n9wxu/fpga_cpu/basic/examples/VALLEY.JPG

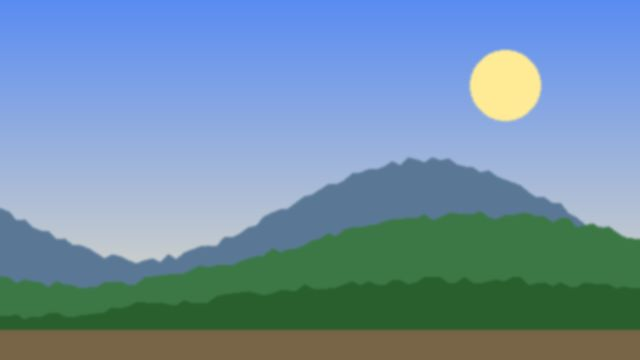
basic/examples/VALLEY.JPG
