n9wxu/fpga_cpu/sim/README.md

# sim

Simulator, assembler and measurement tools for the fpga_cpu ISA. Everything is
driven by [`../cpu/isa.yaml`](../cpu/isa.yaml).

```sh
make -C sim            # generate tables from isa.yaml, build sim/build/fsim (+ fsim-gui if SDL2 is installed)
make -C sim gui        # build sim/build/fsim-gui only
make -C sim test       # ISA self-test, every benchmark on every variant, device test
make -C sim measure    # full sweep -> docs/measurements.md
```

The Makefile creates `.venv/` (PyYAML) on first use. The GUI needs SDL2
(`brew install sdl2`); Dear ImGui is vendored in `third_party/imgui`.

## Layout

| Path | Contents |
|---|---|
| `tools/isa.py` | Loads `isa.yaml`, expands it into individual encodings, checks for overlaps and length-rule violations. Running `isa.py --selftest` does random encode/decode round trips. |
| `tools/gen.py` | Writes the C tables (`src/gen/`, not committed) and the encoding docs (`cpu/gen/encoding_*.md`) |
| `tools/asm.py` | Assembler: picks the shortest encoding that fits, settles branch sizes over repeated passes, writes a listing and per-encoding statistics |
| `tools/measure.py` | Runs every benchmark × variant × timing configuration and checks each output |
| `tools/bench_ref.py` | Python reference results for the benchmarks (`--update` rewrites the `; expect:` lines) |
| `tools/devtest.py` | Device test: runs `demo/devtest.s` headless and checks the keyboard queue, file service and board I/O |
| `tools/profile.py` | Flat profile by function from `fsim --profile` output and a symbol file |
| `tools/memlog.py` | Reads `fsim --log`: cycles, instructions and bus bytes per frame, and frames rebuilt from video-memory writes |
| `tools/mkfont.py` | Builds the 8×14 character ROM (`assets/font8x14.mem` for the FPGA, `src/font8x14.c` for the simulator) from the Terminus BDF |
| `src/cpu.c` | CPU core: decode, memory map, timing model, `cpu_step`/`cpu_run` |
| `src/dev.c` | I/O devices from [docs/io.md](../docs/io.md): console, frame timing, keyboard, video registers, sound, file service, board I/O |
| `src/video.c` | Video renderer: backdrop, bitmap (8-color / hi-color), sprite buffer, text; 640×360 doubled to 1280×720 |
| `src/front.c` | Shared by both front ends: options, image loading, symbols |
| `src/main.c` | Headless front end, `fsim` |
| `src/gui.cpp` | SDL2 + Dear ImGui front end, `fsim-gui` |
| `bench/` | Benchmarks plus `lib.s` (console output, decimal/hex printing, exit) |
| `demo/` | `video.s` (every display layer, double-buffered sprite), `hicolor.s` (palette and dither), `devtest.s` |
| `assets/` | Character ROM: `ter-u14n.bdf` (Terminus, SIL OFL 1.1, see `OFL.TXT`) and the generated `font8x14.mem` |

## Running a program

```sh
.venv/bin/python sim/tools/asm.py -v A prog.s -o prog.bin --lst prog.lst
sim/build/fsim -v A prog.bin              # --trace, --json, timing options: fsim -h
```

Programs start at `.org 0x1000` by default (`--load`, `--entry`). Both
front ends take the same options (`fsim -h`):

| Option | Effect |
|---|---|
| `-v A\|B` | encoding variant |
| `--disk DIR` | host directory served by the file service (default `./disk`) |
| `--sym FILE` | symbols, lines of `%06x name`; used by the GUI's disassembly |
| `--keys STRING` | preload the keyboard queue (`\n` = Enter, `\e` = Esc) |
| `--screenshot FILE` | write the 1280×720 display as PPM at exit |
| `--hw sim\|spartan3\|tang\|big` | the hardware (below): the video tier, the RAM, the colours and the clock; later options override parts of it |
| `--true-color` | show hi-color palette colors instead of the 3-bit dither |
| `--trace`, `--json FILE`, `-q` | headless only: instruction trace, statistics, no summary |
| `--dump A:N:FILE` | headless only: write N bytes of memory from A at exit |
| `--core c0\|c1\|c2\|c3` | a core configuration from the scaling ladder ([docs/cores.md](../docs/cores.md)); later timing options override parts of it |
| `--ext` | allow the optional extension X instructions (`DSTEP`, `MULPU`, `FSHR`, `FSHL`, `CLZ`; [cpu/isa.md](../cpu/isa.md)); without it they trap as illegal |
| `--profile FILE` | headless only: instructions and cycles per address; `tools/profile.py prog.sym FILE` totals them by function |
| `--log FILE` | headless only: a binary record of every instruction (address, length, start cycle) and data access (address, size, value); `tools/memlog.py` reads it |

The I/O registers and the memory layout are in [docs/io.md](../docs/io.md).
Headless, `CON_OUT` goes to stdout and `CON_IN` reads stdin.

## Hardware

`--hw` picks the machine a program was made for (`fsim -h` lists them). The clock is set so a program
runs at about the speed of the board's CPU (its measured MIPS at fsim's cycles per instruction on the
demos, about 1.5); video timing and the low tier's sound follow the clock.

| `--hw` | Machine | Clock | RAM | Video |
|---|---|---|---|---|
| `sim` (default) | the reference machine | 50 MHz | 1 MB | every mode, the 3-bit dither shown |
| `spartan3` | the Spartan-3 board (T1F, about 2 MIPS) | 3 MHz | 1 MB | the low tier: 8- and 16-colour bitmaps, no palette or video extensions; its sound player |
| `tang` | the Tang Nano 20K (T1F, about 6.5 MIPS) | 10 MHz | 8 MB | the high tier in true colour: palette, two playfields, line scroll, sprites, blitter |
| `big` | the reference machine for Doom | 50 MHz | 15 MB | as `sim` |

The Tang's 32-voice audio engine (F01000) is not simulated: the demos that play on it notice and run
silent, keeping time by the video frames.

## Programs

`tools/programs.py` builds the demos and benchmarks (the apps' Makefiles, fcc, the assembler,
`benchmarks/run.py`'s C builds, BASIC with the benchmark programs as its disk) into `build/programs/`
and lists them in `build/programs/catalog.tsv`: name, kind, the hardware it was made for, how to load
it. `--list` shows them; `FCC=...` points at another checkout's toolchain. A program whose build fails is
left out. fsim-gui and the web page (`make -C web progs`) offer what was built.

```sh
.venv/bin/python sim/tools/programs.py      # build/programs/*.bin, catalog.tsv
sim/build/fsim-gui                          # with no image: the first program, on its own hardware
```

## GUI

```sh
sim/build/fsim-gui sim/build/video.bin --sym video.sym
```

| Window | Contents |
|---|---|
| Display | the 1280×720 output. Click it to type: keys go to the keyboard queue as the io.md key codes |
| Controls | Run (F5), Stop, Step (F11), Step Over (F10, steps over `JAL`/`JALR`), Step Out (runs until a `JR` returns from the current frame), Reset (reloads the image), speed: real time (at the hardware's clock) or as fast as possible |
| Program and hardware | the program (demos, benchmarks and programs from the catalogue, `--programs FILE`) and the hardware (`--hw`); a choice builds the machine again. A program brings its own hardware; another can be picked after it |
| Registers | r0–r15 (editable while stopped), the pairs with symbol names, PC, NZCV, cycles, frame and scan line |
| Disassembly | follows the PC, shows labels from `--sym`; click a line to toggle a breakpoint; go to an address or symbol |
| Memory | hex and ASCII over the whole 24-bit space; go to an address or symbol |
| Serial console | `CON_OUT` text; a line typed here is sent to `CON_IN` with `\n` |
| Board | the starter board's 7-segment display, LEDs, slide switches and push buttons |
| Statistics | IPC, I-cache, branches, stall breakdown, fusion candidates |

Sound plays the three voices through SDL audio. The window layout is
saved in `~/.fsim_gui.ini`.

Scripted runs, for checking the GUI without clicking:
`--paused` starts stopped; `--frames N --screenshot-window FILE.bmp` runs N
display frames, saves the whole window and exits; `FSIM_GUI_SELFTEST=1`
checks breakpoints, Step Over/Out and key translation on `demo/video.s`.

## Assembly syntax

```asm
        ADD   r1, r2, r3        ; three-operand
        ADD   r1, r2            ; r1 = r1 + r2 (assembler picks the 16-bit form)
        LDW   r1, [p2 + 6]      ; pair + displacement
        LDW   r1, [p2 + r3*2]   ; pair + sign-extended index (r3.z*2 = zero-extended)
        LDW   r1, [p2]+         ; post-increment     STW r1, -[p2]   pre-decrement
        LDW   r1, [label]       ; direct (variant A expands to LEA p0 + LDW)
        BNE   loop              ; EQ NE CS/HS CC/LO MI PL VS VC HI LS GE LT GT LE AL/RA
```

- Registers are `r0`–`r15`. Pairs are `p0`–`p7`, with `sp` = `p7` and `lr` = `p6`.
- Pseudo-instructions: `LI LA CALL RET PUSH POP PUSHP POPP INC DEC CLR TST`.
- Directives: `.org .equ .byte .word .long .ascii .asciz .align .space .include`, and `.ifdef NAME` / `.ifndef NAME` / `.else` / `.endif` with names from `asm.py -D NAME`.

## Timing model

CPU and SRAM share one 50 MHz clock and one 32-bit memory port.

`--xram MB` adds simulator-only expansion RAM at `100000` (up to 14 MB,
to `EFFFFF`), with the same timing as the SRAM, for programs larger than
the base board (benchmarks/doom). Without it, that range is unmapped.

- **Every instruction takes 1 cycle**, plus:
  - I-cache misses: 1 cycle to start, then 1 cycle per word, word by word.
  - The stream buffer prefetches the next line during idle port cycles.
  - Taken branches: 2 cycles.
  - A load whose result the next instruction uses: 1 cycle.
  - Video scan-out takes port cycles: 4 every 56 by default.
  - Each I/O access: 2 cycles.
  - A 32-bit pair access that spans two SRAM words: 1 cycle.
- **Fusion candidates are always counted.** `--fuse` applies them: the second instruction issues free when both instructions fit in the 64-bit fetch window.
  - Kinds: `cmpbr` (CMP/CMPI/CPC + Bcc), `addadc` (ADD+ADC or SUB+SBC on a pair), `leamem` (LEA + a load or store through that pair), `ldpair` (two LDW or STW to adjacent words) and `alubr` (any other flag-setting ALU op + Bcc, so `DEC r; BNE loop` behaves like a DBNZ instruction).
  - `--fuse=cmpbr,alubr` applies only the listed kinds. Candidates are counted the same way whatever is applied.
- **Dual issue** (`--dual`): an instruction issues free beside the one before it when slot 2 can take it and the two are independent.
  - Slot 1 takes anything except a control transfer. Slot 2 takes a simple ALU op (no shift, multiply or pointer op), `MOVI`, or a branch.
  - The pair must fit the fetch window, and slot 2 must not read a register or the flags that slot 1 writes, or write the same register.
  - `--dual` (banked) gives the register file one write port per even/odd bank, so the two must write opposite banks. `--dual=ports` models a full second write port.
  - Fusion is tried first. An instruction joins at most one group, so there is no three-way issue.
- **SRAM port counters:** words used by I-fetch (misses, stream buffer) and data, plus the instruction bytes the core consumes per cycle. `make measure` reports them, and estimates speed per LUT for each option.
