n9wxu/fpga_cpu/pcb/README.md

# pcb

RP2350 expansion board for headers A2/B1: SD card, keyboard, sound (PWM + amplifier), RTC, and the UART link to the FPGA.

Future expansion (VRAM, HDMI, game controllers) is not designed yet.
