n9wxu/fpga_cpu/apps/sidplay/out/screen_syncrider.png

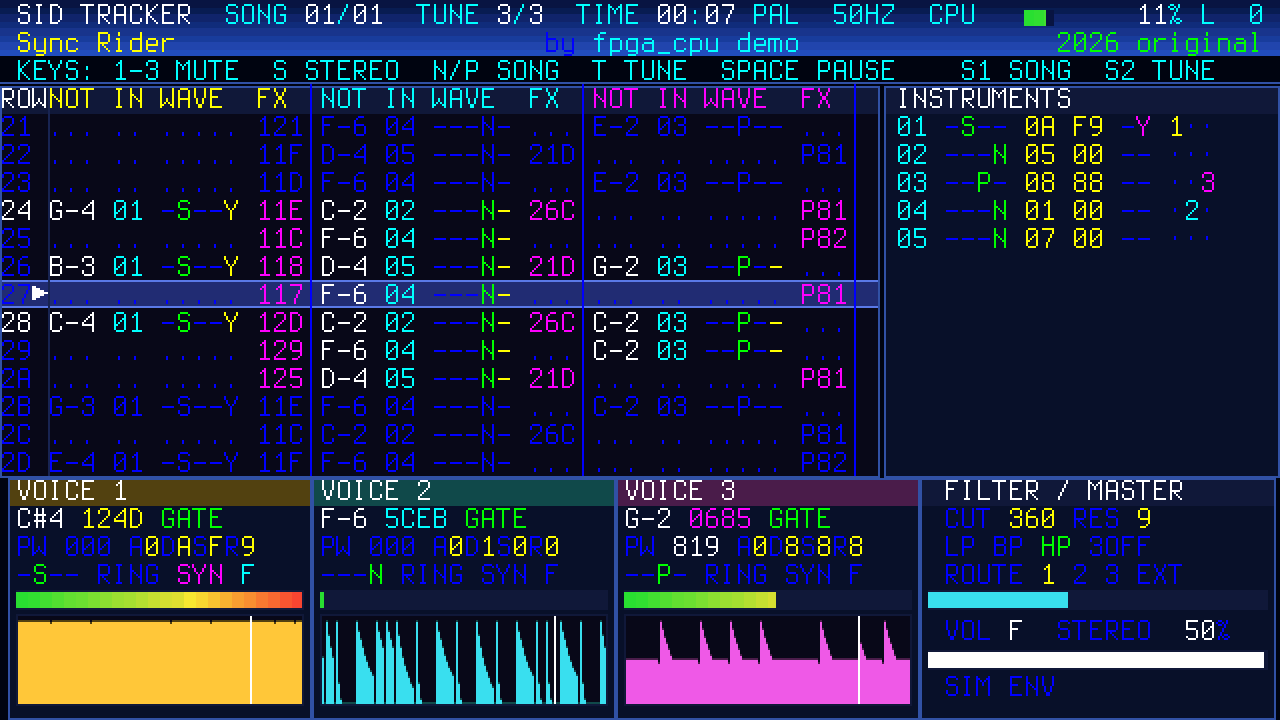
apps/sidplay/out/screen_syncrider.png
