n9wxu/fpga_cpu/docs/measurements.md

# Measurements

Generated by `sim/tools/measure.py`. Do not edit; rerun `make -C sim measure`.

The benchmarks are hand-written assembly (`sim/bench`). They show how the encodings and the
timing model behave, but they are small and fit in any I-cache. Code-size and I-cache
conclusions need compiled code: the BASIC interpreter via the LLVM backend.

CPU and SRAM share one 50 MHz clock. Every run was checked against the Python reference results.

## Opcode space

| variant | 16-bit share | 16-bit used | 32-bit share | 32-bit used | encodings |
|---|---|---|---|---|---|
| A | 81.2% | 96.1% | 18.8% | 85.7% | 153 |
| B | 50.0% | 94.8% | 50.0% | 69.6% | 151 |

## Static code size

| benchmark | A bytes | A 16-bit | B bytes | B 16-bit | B/A | B expanded |
|---|---|---|---|---|---|---|
| arith32 | 252 | 76% | 262 | 72% | 1.040 | 0 |
| fib | 200 | 70% | 210 | 64% | 1.050 | 0 |
| hello | 150 | 73% | 160 | 64% | 1.067 | 0 |
| lines | 274 | 75% | 286 | 70% | 1.044 | 0 |
| memops | 300 | 64% | 310 | 59% | 1.033 | 0 |
| sieve | 228 | 73% | 242 | 66% | 1.061 | 0 |
| tokenize | 328 | 83% | 350 | 75% | 1.067 | 0 |
| **total** | **1732** | | **1820** | | **1.051** | |

## Dynamic performance (base configuration)

| benchmark | insts | A cycles | A CPI | A 16-bit exec | B cycles | B CPI | B/A |
|---|---|---|---|---|---|---|---|
| arith32 | 140723 | 181028 | 1.286 | 72% | 181034 | 1.286 | 1.0000 |
| fib | 208041 | 335884 | 1.615 | 68% | 335879 | 1.614 | 1.0000 |
| hello | 82 | 198 | 2.415 | 93% | 193 | 2.354 | 0.9747 |
| lines | 810610 | 1255810 | 1.549 | 96% | 1255815 | 1.549 | 1.0000 |
| memops | 155962 | 254232 | 1.630 | 97% | 254255 | 1.630 | 1.0001 |
| sieve | 722099 | 1114745 | 1.544 | 69% | 1114746 | 1.544 | 1.0000 |
| tokenize | 648700 | 1114640 | 1.718 | 92% | 1114640 | 1.718 | 1.0000 |
| **geomean** | | | | | | | **0.9964** |

## Where the cycles go (variant A, base)

| benchmark | issue | ifetch | taken branch | load-use | video | I/O | pair split |
|---|---|---|---|---|---|---|---|
| arith32 | 78% | 0.0% | 22.2% | 0.0% | 0.0% | 0.0% | 0.0% |
| fib | 62% | 0.0% | 32.6% | 3.3% | 2.2% | 0.0% | 0.0% |
| hello | 41% | 16.2% | 18.2% | 7.6% | 1.5% | 15.2% | 0.0% |
| lines | 65% | 0.0% | 26.1% | 9.2% | 0.1% | 0.0% | 0.0% |
| memops | 61% | 0.0% | 27.4% | 10.5% | 0.7% | 0.0% | 0.0% |
| sieve | 65% | 0.0% | 31.0% | 2.9% | 1.2% | 0.0% | 0.0% |
| tokenize | 58% | 0.0% | 24.5% | 13.1% | 4.2% | 0.0% | 0.0% |

## Fusion candidates (variant A), per 100 instructions

| benchmark | cmp+branch | add+adc pair | lea+mem | ldw/stw pair | alu+branch | speedup with fusion |
|---|---|---|---|---|---|---|
| arith32 | 14.3 | 14.2 | 0.0 | 0.0 | 0.1 | 1.285x |
| fib | 10.5 | 0.0 | 0.0 | 0.0 | 0.0 | 1.078x |
| hello | 18.3 | 0.0 | 1.2 | 0.0 | 0.0 | 1.076x |
| lines | 7.9 | 0.0 | 0.0 | 0.0 | 18.2 | 1.169x |
| memops | 0.0 | 0.0 | 0.0 | 0.0 | 22.3 | 1.153x |
| sieve | 20.0 | 0.0 | 0.0 | 0.0 | 4.5 | 1.166x |
| tokenize | 28.7 | 0.0 | 0.0 | 0.0 | 0.0 | 1.232x |
| **geomean** |  |  |  |  |  | **1.163x** |

## Fusion candidates (variant B), per 100 instructions

| benchmark | cmp+branch | add+adc pair | lea+mem | ldw/stw pair | alu+branch | speedup with fusion |
|---|---|---|---|---|---|---|
| arith32 | 14.3 | 14.2 | 0.0 | 0.0 | 0.1 | 1.285x |
| fib | 10.5 | 0.0 | 0.0 | 0.0 | 0.0 | 1.078x |
| hello | 18.3 | 0.0 | 1.2 | 0.0 | 0.0 | 1.078x |
| lines | 7.9 | 0.0 | 0.0 | 0.0 | 18.2 | 1.169x |
| memops | 0.0 | 0.0 | 0.0 | 0.0 | 22.3 | 1.153x |
| sieve | 20.0 | 0.0 | 0.0 | 0.0 | 4.5 | 1.166x |
| tokenize | 28.7 | 0.0 | 0.0 | 0.0 | 0.0 | 1.232x |
| **geomean** |  |  |  |  |  | **1.164x** |

## Dual issue (variant A)

Slot 2 takes simple ALU ops, MOVI or a branch; slot 1 takes anything but a control transfer. Paired instructions must be independent (no register or flag dependence). Banked: the two must write opposite even/odd register banks.

| benchmark | paired, banked | paired, ports | slot 2 alu / movi / branch | top blockers (banked) | speedup banked | speedup ports | dual + branch fusion |
|---|---|---|---|---|---|---|---|
| arith32 | 28.5% | 28.5% | 100 / 0 / 0% | flags 14%, slot2 14% | 1.284x | 1.285x | 1.499x |
| fib | 5.3% | 10.5% | 100 / 0 / 0% | slot2 32%, flags 11% | 1.039x | 1.078x | 1.102x |
| hello | 17.1% | 17.1% | 0 / 0 / 100% | raw 18%, flags 18% | 1.070x | 1.070x | 1.193x |
| lines | 21.6% | 23.9% | 100 / 0 / 0% | raw 14%, flags 8% | 1.125x | 1.153x | 1.206x |
| memops | 5.3% | 22.4% | 100 / 0 / 0% | bank 22%, flags 17% | 1.038x | 1.153x | 1.153x |
| sieve | 15.5% | 20.6% | 71 / 0 / 29% | flags 24%, slot1 15% | 1.099x | 1.133x | 1.326x |
| tokenize | 4.9% | 4.9% | 7 / 3 / 90% | flags 29%, raw 26% | 1.042x | 1.042x | 1.254x |
| **geomean** | | | | | **1.097x** | **1.128x** | **1.242x** |

Blockers are counted per instruction: window = the pair does not fit the fetch window, slot1/slot2 = an instruction class the slot cannot take, raw/waw = register dependence, bank = both write the same bank, flags = slot 2 reads flags that slot 1 writes.

## SRAM port use (variant A, all benchmarks)

Share of all cycles. Video is the fixed scan-out reservation (4 of every 56 cycles). Demand is the instruction bytes the core consumes per cycle; the port can supply 4.

| configuration | instruction fetch | data | video | idle | demand B/cycle | cycles vs base |
|---|---|---|---|---|---|---|
| base | 0.0% | 13.5% | 7.1% | 79.4% | 1.46 | 1.000 |
| fuse-br | 0.0% | 15.8% | 7.1% | 77.0% | 1.71 | 0.877 |
| dual+br | 0.0% | 16.8% | 7.1% | 76.1% | 1.82 | 0.805 |
| ic64 | 2.3% | 13.3% | 7.1% | 77.3% | 1.44 | 1.008 |
| ic64+dual+br | 2.8% | 16.5% | 7.1% | 73.6% | 1.78 | 0.814 |
| nocache | 62.0% | 12.2% | 7.1% | 18.7% | 1.32 | 1.063 |
| nocache+br | 72.5% | 14.3% | 7.1% | 6.1% | 1.54 | 0.935 |
| nocache+dual | 68.0% | 13.4% | 7.1% | 11.5% | 1.45 | 0.969 |

The benchmarks fit in a 64 B cache except `tokenize` and `hello`, so the miss path is only really exercised by the no-cache rows until compiled BASIC is measured.

## Speed per LUT (variant A, estimates)

LUT figures are design estimates in `sim/tools/measure.py`, not synthesis results. Speedup is the geomean over benchmarks against base.

| option | speedup | extra LUTs (est.) | speedup % per 100 LUTs | what the LUTs buy |
|---|---|---|---|---|
| bp1 | 1.140x | 30–80 | 25.5 | resolve taken branches one stage earlier: target adder and redirect in decode |
| fuse-cmpbr | 1.095x | 30–60 | 21.2 | pair detect, flags forwarded straight into the branch decision |
| fuse-br | 1.141x | 40–80 | 23.4 | as fuse-cmpbr, plus the register write of the ALU half |
| fuse | 1.163x | 150–250 | 8.2 | all kinds: adds a 32-bit carry across ADD+ADC, LEA into the AGU, paired LDW/STW |
| dual | 1.097x | 300–450 | 2.6 | slot-2 decoder and 16-bit ALU, two more register-file read copies, forwarding, pairing check, flag merge |
| dual-ports | 1.128x | 360–570 | 2.8 | as dual, plus a second full write port (replicated file or LVT) |

## Configuration sweep: cycles relative to base (geomean over benchmarks)

| configuration | description | A | B |
|---|---|---|---|
| fuse | base + macro-op fusion | 0.859 | 0.859 |
| noprefetch | base without the stream buffer | 1.000 | 1.000 |
| nocache | no I-cache: every fetch from SRAM | 1.063 | 1.075 |
| ic512 | 512 B I-cache | 1.000 | 1.000 |
| ic1k | 1 KB I-cache | 1.000 | 1.000 |
| ic4k | 4 KB I-cache | 1.000 | 1.000 |
| line8 | 8 B lines | 0.992 | 0.993 |
| line32 | 32 B lines | 1.002 | 0.999 |
| novideo | no video traffic | 0.983 | 0.983 |
| bp1 | 1-cycle taken-branch penalty | 0.877 | 0.877 |
| fuse-cmpbr | fuse CMP+Bcc only | 0.913 | 0.913 |
| fuse-br | fuse CMP+Bcc and ALU+Bcc (DEC+BNE = DBNZ) | 0.877 | 0.876 |
| dual | dual issue, even/odd write banks | 0.912 | 0.911 |
| dual-ports | dual issue, full second write port | 0.886 | 0.886 |
| dual+br | dual issue (banked) + branch fusion | 0.805 | 0.805 |
| bp1+br | 1-cycle branch + branch fusion | 0.745 | 0.744 |
| bp1+dual+br | 1-cycle branch + dual (banked) + branch fusion | 0.677 | 0.676 |
| nocache+br | no I-cache + branch fusion | 0.935 | 0.945 |
| nocache+dual | no I-cache + dual issue | 0.969 | 0.978 |
| ic64 | 64 B I-cache (miss-path stress) | 1.008 | 1.009 |
| ic64+br | 64 B I-cache + branch fusion | 0.886 | 0.886 |
| ic64+dual+br | 64 B I-cache + dual + branch fusion | 0.814 | 0.814 |

## I-cache misses per 1000 instructions

| benchmark | A ic512 | A ic1k | A base | B ic512 | B ic1k | B base |
|---|---|---|---|---|---|---|
| arith32 | 0.05 | 0.05 | 0.05 | 0.06 | 0.06 | 0.06 |
| fib | 0.03 | 0.03 | 0.03 | 0.02 | 0.02 | 0.02 |
| hello | 48.78 | 48.78 | 48.78 | 48.78 | 48.78 | 48.78 |
| lines | 0.00 | 0.00 | 0.00 | 0.00 | 0.00 | 0.00 |
| memops | 0.04 | 0.04 | 0.04 | 0.05 | 0.05 | 0.05 |
| sieve | 0.01 | 0.01 | 0.01 | 0.01 | 0.01 | 0.01 |
| tokenize | 0.01 | 0.01 | 0.01 | 0.01 | 0.01 | 0.01 |

## Most executed encodings (variant A, all benchmarks)

| encoding | share |
|---|---|
| `B/16` | 29.3% |
| `ADDI/16` | 11.4% |
| `ADD/16` | 11.1% |
| `CMPI/16` | 7.3% |
| `LDW.pi/16` | 5.8% |
| `CMP/16` | 4.8% |
| `CMPI/32` | 4.2% |
| `LDBU.pi/16` | 3.6% |
| `LDBU.x/32,ext=0,scale=1` | 2.9% |
| `STB.x/32,ext=0,scale=1` | 2.8% |
| `STB.pi/16` | 1.8% |
| `ADDP/16` | 1.7% |
| `ADD/32` | 1.3% |
| `LDBU.d/16` | 1.3% |
| `STB.d/16` | 1.2% |

## Most executed encodings (variant B, all benchmarks)

| encoding | share |
|---|---|
| `B/16` | 29.3% |
| `ADDI/16` | 11.4% |
| `ADD/16` | 11.1% |
| `CMPI/16` | 7.3% |
| `LDW.pi/16` | 5.8% |
| `CMP/16` | 4.8% |
| `CMPI/32` | 4.2% |
| `LDBU.pi/16` | 3.6% |
| `LDBU.x/32,ext=0,scale=1` | 2.9% |
| `STB.x/32,ext=0,scale=1` | 2.8% |
| `STB.pi/16` | 1.8% |
| `ADDP/16` | 1.7% |
| `ADD/32` | 1.3% |
| `LDBU.d/32` | 1.3% |
| `STB.d/32` | 1.2% |
