n9wxu/fpga_cpu/pcb/s3_expansion/s3_expansion.pdf

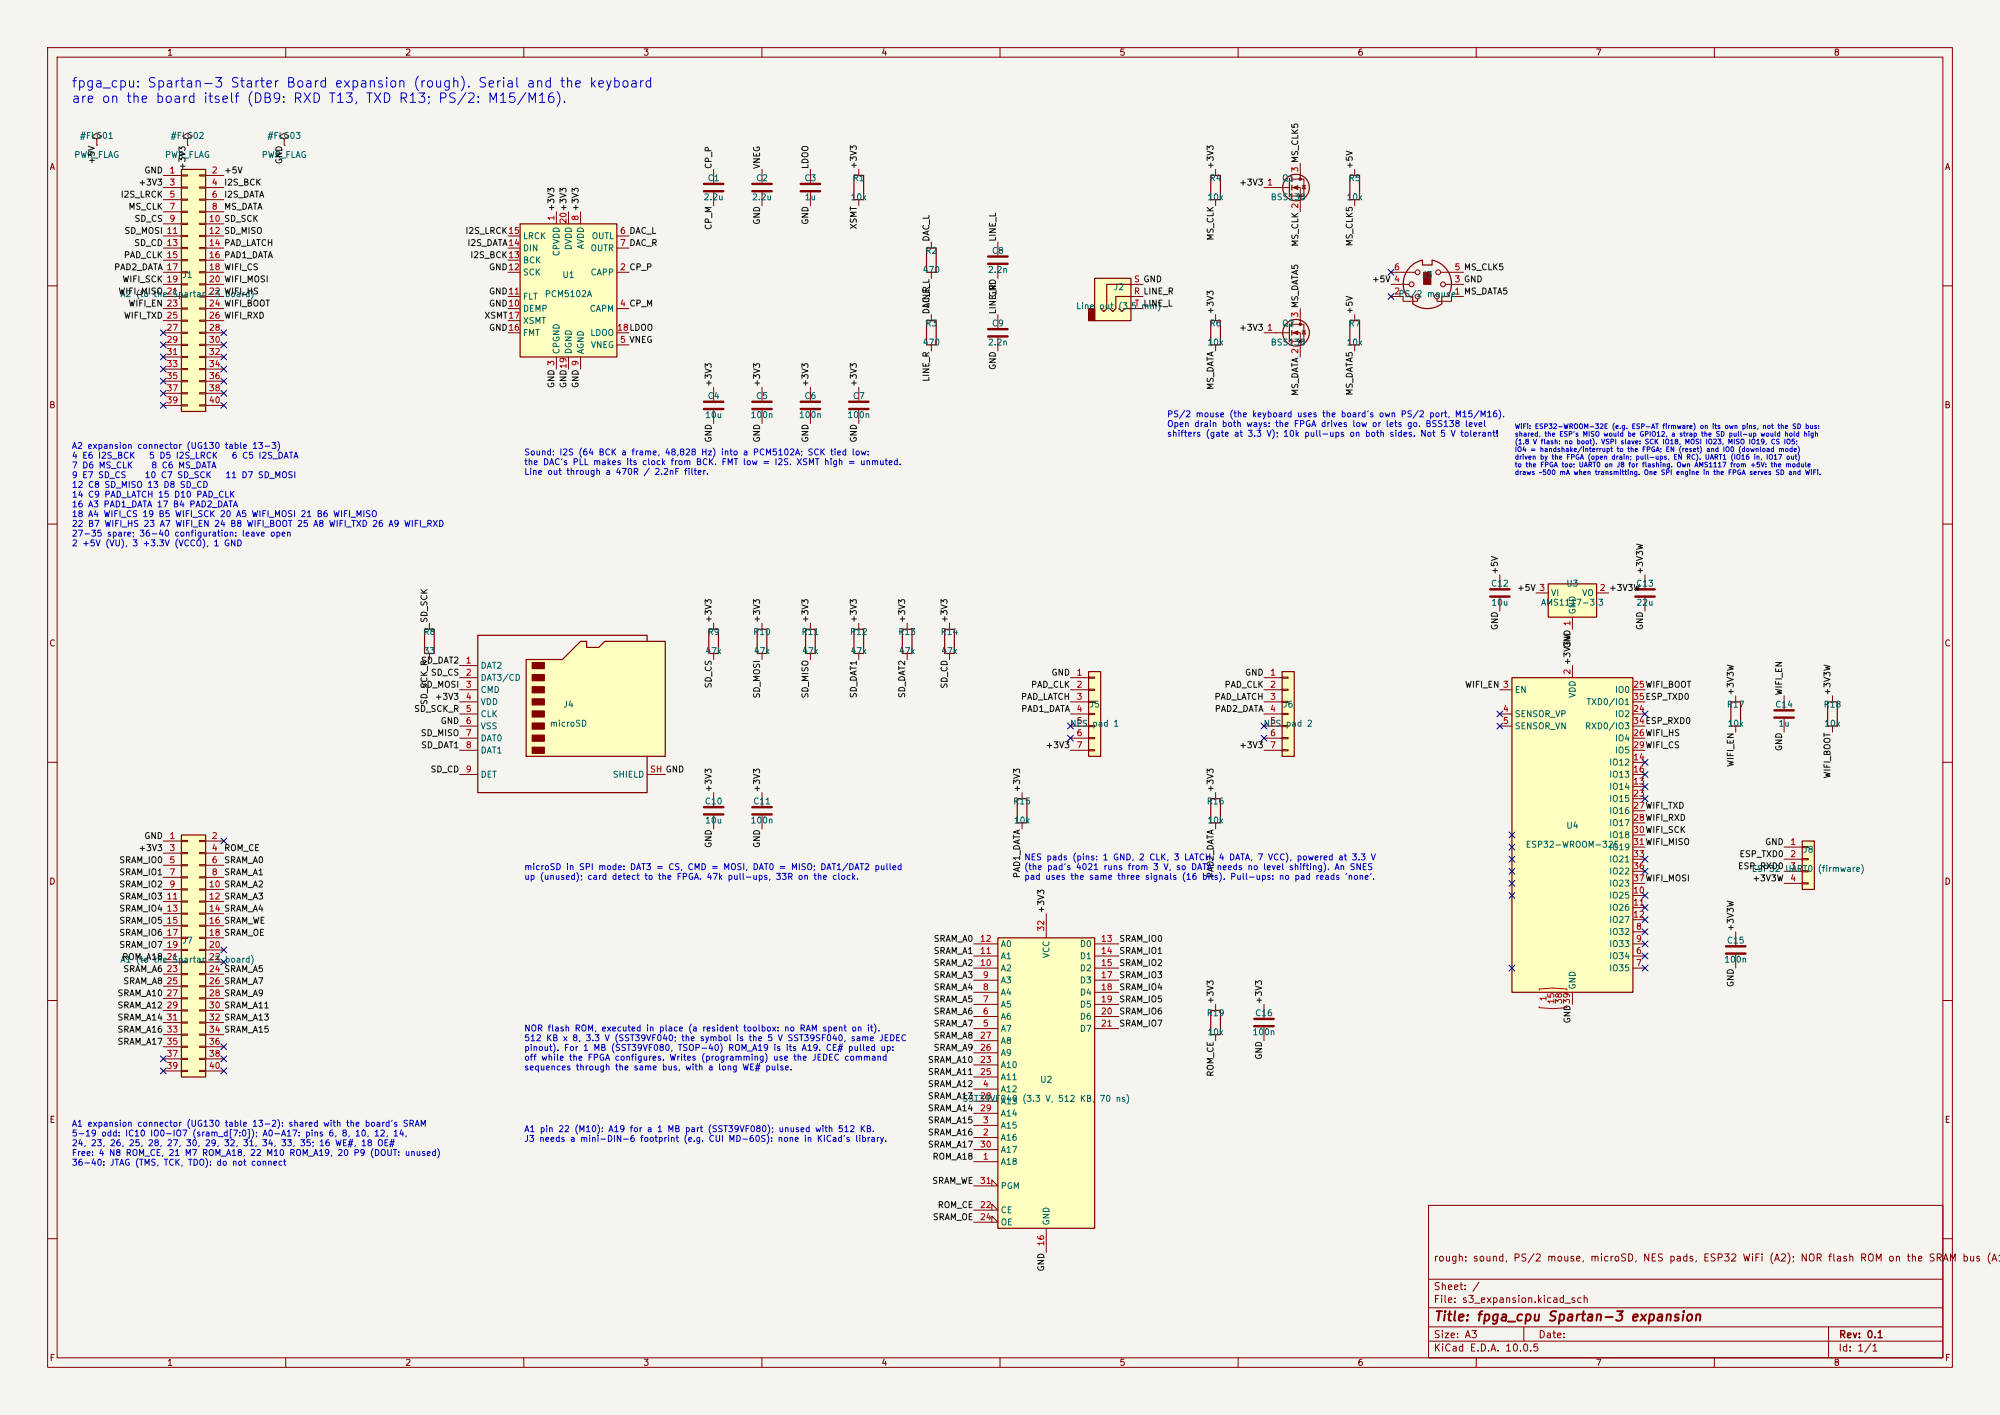
[picture p3: page 1]

fpga_cpu: Spartan-3 Starter Board expansion (rough). Serial and the keyboard
are on the board itself (DB9: RXD T13, TXD R13; PS/2: M15/M16).

+3V3 MS_CLK +3V3
J3 PS/2 mouse GND 16 VCC 32

SCK 12 BCK 13 DIN 14 LRCK 15

PS/2 mouse (the keyboard uses the board's own PS/2 port, M15/M16).

Sound: I2S (64 BCK a frame, 48,828 Hz) into a PCM5102A; SCK tied low: the DAC's PLL makes its clock from BCK. FMT low = I2S. XSMT high = unmuted. Line out through a 470R / 2.2nF filter. microSD in SPI mode: DAT3 = CS, CMD = MOSI, DAT0 = MISO; DAT1/DAT2 pulled

(1.8 V flash: no boot). VSPI slave: SCK IO18, MOSI IO23, MISO IO19, CS IO5;
IO4 = handshake/interrupt to the FPGA; EN (reset) and IO0 (download mode) driven by the FPGA (open drain; pull-ups, EN RC). UART1 (IO16 in, IO17 out)

to the FPGA too; UART0 on J8 for flashing. Own AMS1117 from +5V: the module draws ~500 mA when transmitting. One SPI engine in the FPGA serves SD and WiFi.

(the pad's 4021 runs from 3 V, so DATA needs no level shifting). An SNES
pad uses the same three signals (16 bits). Pull-ups: no pad reads 'none'.

up (unused); card detect to the FPGA. 47k pull-ups, 33R on the clock. NOR flash ROM, executed in place (a resident toolbox: no RAM spent on it). 512 KB x 8, 3.3 V (SST39VF040; the symbol is the 5 V SST39SF040, same JEDEC

pinout). For 1 MB (SST39VF080, TSOP-40) ROM_A19 is its A19. CE# pulled up: off while the FPGA configures. Writes (programming) use the JEDEC command

sequences through the same bus, with a long WE# pulse. A1 pin 22 (M10): A19 for a 1 MB part (SST39VF080); unused with 512 KB. J3 needs a mini-DIN-6 footprint (e.g. CUI MD-60S): none in KiCad's library.

5-19 odd: IC10 IO0-IO7 (sram_d[7:0]); A0-A17: pins 6, 8, 10, 12, 14,
Free: 4 N8 ROM_CE, 21 M7 ROM_A18, 22 M10 ROM_A19, 20 P9 (DOUT: unused) 36-40: JTAG (TMS, TCK, TDO): do not connect

A1 expansion connector (UG130 table 13-2): shared with the board's SRAM

rough: sound, PS/2 mouse, microSD, NES pads, ESP32 WiFi (A2); NOR flash ROM on the SRAM bus (A1)

Size: A3 | Rev: 0.1 | F Date:
KiCad E.D.A. 10.0.5 | Id: 1/1
