n9wxu/fpga_cpu/basic/src/eval.c

/* Expression evaluator.
 *
 * Values live on an explicit stack (vs[]), so the string collector can
 * find every temporary. Precedence, lowest first:
 *   OR, AND, NOT, relations, + -, * / \ MOD, unary -, ^
 * Integer (%) operands stay integers through + - * \ MOD and
 * relations while the result fits in 16 bits; / always gives a float.
 */
#include <math.h>

#include "basic.h"

#define FLT_BIG 3.4028235e38f

static void e_or(void);
void expr(void) { e_or(); }

void need(uint8_t t)
{
    if (*ip != t)
        error(E_SN);
    ip++;
}

static val_t *push(void)
{
    if (vsp >= VSMAX)
        error(E_ST);
    return &vs[vsp++];
}

void push_num(float f)
{
    val_t *v;
    if (f > FLT_BIG || f < -FLT_BIG || f != f)
        error(E_OV);
    v = push();
    v->t = T_NUM;
    v->u.f = f;
}

void push_int(int32_t i)
{
    if (i < -32768L || i > 32767L) {
        push_num((float)i);
        return;
    }
    {
        val_t *v = push();
        v->t = T_INT;
        v->u.i = (int16_t)i;
    }
}

void push_newstr(const char *s, uint16_t len)
{
    val_t *v;
    char *p = NULL;
    if (len)
        p = str_alloc(len);
    if (len)
        memcpy(p, s, len);
    v = push();
    v->t = T_STR;
    v->u.s.p = p;
    v->u.s.len = len;
}

float num_of(const val_t *v)
{
    if (v->t == T_NUM)
        return v->u.f;
    if (v->t == T_INT)
        return (float)v->u.i;
    error(E_TM);
}

str_t sval(const val_t *v)
{
    if (v->t == T_STR)
        return v->u.s;
    if (v->t == T_SREF)
        return *v->u.r;
    error(E_TM);
}

float pop_num(void)
{
    vsp--;
    return num_of(&vs[vsp]);
}

int32_t to_i32(float f)
{
    if (f >= 2147483647.0f || f < -2147483647.0f)
        error(E_FC);
    return (int32_t)floorf(f);
}

int16_t to_i16(float f)
{
    if (f >= 32768.0f || f < -32768.0f)
        error(E_FC);
    return (int16_t)floorf(f);
}

int16_t pop_i16(void)
{
    vsp--;
    if (vs[vsp].t == T_INT)
        return vs[vsp].u.i;
    return to_i16(num_of(&vs[vsp]));
}

int32_t pop_i32(void)
{
    vsp--;
    if (vs[vsp].t == T_INT)
        return vs[vsp].u.i;
    return to_i32(num_of(&vs[vsp]));
}

/* 16-bit pattern for AND/OR/NOT: accepts -32768..65535. */
static uint16_t pop_bits(void)
{
    float f;
    vsp--;
    if (vs[vsp].t == T_INT)
        return (uint16_t)vs[vsp].u.i;
    f = num_of(&vs[vsp]);
    if (f >= 65536.0f || f < -32768.0f)
        error(E_FC);
    return (uint16_t)(int32_t)floorf(f);
}

/* Store the top of the stack in a string variable, then pop it. A heap
 * temporary is moved; anything else is copied. */
void assign_str(str_t *dst)
{
    val_t *v = &vs[vsp - 1];
    str_t s = sval(v);
    char *p;
    if (v->t == T_STR && s.p && (uint8_t *)s.p >= str_bot && (uint8_t *)s.p < arena_top) {
        *dst = s;
        vsp--;
        return;
    }
    if (!s.len) {
        dst->p = NULL;
        dst->len = 0;
        vsp--;
        return;
    }
    p = str_alloc(s.len); /* may move strings: fetch the source again */
    s = sval(v);
    memcpy(p, s.p, s.len);
    dst->p = p;
    dst->len = s.len;
    vsp--;
}

/* Replace the string on top of the stack with a copy of part of it. */
static void top_substr(uint16_t off, uint16_t n)
{
    val_t *v = &vs[vsp - 1];
    str_t s;
    char *p = NULL;
    if (n) {
        p = str_alloc(n);
        s = sval(v);
        memcpy(p, s.p + off, n);
    }
    v->t = T_STR;
    v->u.s.p = p;
    v->u.s.len = n;
}

static int is_num(const val_t *v) { return v->t == T_NUM || v->t == T_INT; }

static int cmp_str(void)
{
    str_t a = sval(&vs[vsp - 2]), b = sval(&vs[vsp - 1]);
    uint16_t n = a.len < b.len ? a.len : b.len;
    int c = n ? memcmp(a.p, b.p, n) : 0;
    if (!c)
        c = a.len < b.len ? -1 : a.len > b.len;
    return c < 0 ? -1 : c > 0;
}

static int rel_true(uint8_t op, int c)
{
    switch (op) {
    case '=': return c == 0;
    case '<': return c < 0;
    case '>': return c > 0;
    case TK_LE: return c <= 0;
    case TK_GE: return c >= 0;
    default: return c != 0; /* TK_NE */
    }
}

static int is_rel(uint8_t op)
{
    return op == '=' || op == '<' || op == '>' || op == TK_LE || op == TK_GE || op == TK_NE;
}

static float fpow(float x, float y)
{
    if (y == floorf(y) && y >= -64.0f && y <= 64.0f) {
        int n = (int)(y < 0 ? -y : y);
        float r = 1.0f, b = x;
        while (n) {
            if (n & 1)
                r *= b;
            b *= b;
            n >>= 1;
        }
        if (y < 0) {
            if (r == 0)
                error(E_DZ);
            r = 1.0f / r;
        }
        return r;
    }
    if (x < 0)
        error(E_FC);
    if (x == 0)
        return 0;
    return powf(x, y);
}

static void binop(uint8_t op)
{
    val_t *a = &vs[vsp - 2], *b = &vs[vsp - 1];

    if (!is_num(a) || !is_num(b)) {
        if (is_num(a) || is_num(b))
            error(E_TM);
        if (op == '+') {
            str_t sa = sval(a), sb = sval(b);
            uint16_t n = (uint16_t)(sa.len + sb.len);
            char *p;
            if (n > 255)
                error(E_LS);
            p = n ? str_alloc(n) : NULL;
            sa = sval(a);
            sb = sval(b);
            if (sa.len)
                memcpy(p, sa.p, sa.len);
            if (sb.len)
                memcpy(p + sa.len, sb.p, sb.len);
            vsp--;
            a->t = T_STR;
            a->u.s.p = p;
            a->u.s.len = n;
            return;
        }
        if (is_rel(op)) {
            int c = cmp_str();
            vsp -= 2;
            push_int(rel_true(op, c) ? -1 : 0);
            return;
        }
        error(E_TM);
    }

    if (a->t == T_INT && b->t == T_INT && op != '/' && op != '^') {
        int32_t x = a->u.i, y = b->u.i, r;
        vsp -= 2;
        switch (op) {
        case '+': r = x + y; break;
        case '-': r = x - y; break;
        case '*': r = x * y; break;
        case '\\':
            if (!y)
                error(E_DZ);
            r = x / y;
            break;
        case KW_MOD:
            if (!y)
                error(E_DZ);
            r = x % y;
            break;
        default: r = rel_true(op, x < y ? -1 : x > y) ? -1 : 0; break;
        }
        push_int(r);
        return;
    }

    {
        float x = num_of(a), y = num_of(b), r;
        vsp -= 2;
        switch (op) {
        case '+': r = x + y; break;
        case '-': r = x - y; break;
        case '*': r = x * y; break;
        case '/':
            if (y == 0)
                error(E_DZ);
            r = x / y;
            break;
        case '^': r = fpow(x, y); break;
        case '\\': {
            int32_t ix = to_i32(x), iy = to_i32(y);
            if (!iy)
                error(E_DZ);
            push_int(ix / iy);
            return;
        }
        case KW_MOD:
            if (y == 0)
                error(E_DZ);
            r = fmodf(x, y);
            break;
        default: push_int(rel_true(op, x < y ? -1 : x > y) ? -1 : 0); return;
        }
        push_num(r);
    }
}

static void negate(void)
{
    val_t *v = &vs[vsp - 1];
    if (v->t == T_INT) {
        if (v->u.i == -32768) {
            v->t = T_NUM;
            v->u.f = 32768.0f;
        } else
            v->u.i = (int16_t)-v->u.i;
    } else if (v->t == T_NUM)
        v->u.f = -v->u.f;
    else
        error(E_TM);
}

/* ---- functions ---- */

static uint32_t rnd_state = 0x2545F491UL;
static float rnd_last = 0.5f;

void rnd_seed(uint32_t s) { rnd_state = s ? s : 0x2545F491UL; }

static float rnd(float x)
{
    if (x < 0) {
        union { float f; uint32_t u; } u;
        u.f = x;
        rnd_seed(u.u * 2654435761UL);
    } else if (x == 0)
        return rnd_last;
    rnd_state ^= rnd_state << 13;
    rnd_state ^= rnd_state >> 17;
    rnd_state ^= rnd_state << 5;
    rnd_last = (float)(rnd_state >> 8) * (1.0f / 16777216.0f);
    return rnd_last;
}

static void paren_expr(void)
{
    need('(');
    expr();
    need(')');
}

static float paren_num(void)
{
    paren_expr();
    return pop_num();
}

static void str_func(uint8_t t)
{
    char buf[16];
    switch (t) {
    case KW_LEFTS:
    case KW_RIGHTS: {
        int32_t n;
        str_t s;
        need('(');
        expr();
        need(',');
        expr();
        need(')');
        n = pop_i32();
        if (n < 0 || n > 255)
            error(E_FC);
        s = sval(&vs[vsp - 1]);
        if (n > s.len)
            n = s.len;
        top_substr(t == KW_LEFTS ? 0 : (uint16_t)(s.len - n), (uint16_t)n);
        return;
    }
    case KW_MIDS: {
        int32_t st, n = 255;
        str_t s;
        need('(');
        expr();
        need(',');
        expr();
        if (*ip == ',') {
            ip++;
            expr();
            n = pop_i32();
        }
        need(')');
        st = pop_i32();
        if (st < 1 || st > 255 || n < 0 || n > 255)
            error(E_FC);
        s = sval(&vs[vsp - 1]);
        if (st > s.len)
            n = 0;
        else if (st - 1 + n > s.len)
            n = s.len - (st - 1);
        top_substr((uint16_t)(st - 1), (uint16_t)n);
        return;
    }
    case KW_CHRS: {
        int32_t c = (int32_t)paren_num();
        if (c < 0 || c > 255)
            error(E_FC);
        buf[0] = (char)c;
        push_newstr(buf, 1);
        return;
    }
    case KW_STRS: {
        int n = fmt_num(paren_num(), buf);
        push_newstr(buf, (uint16_t)n);
        return;
    }
    case KW_HEXS: {
        float f = paren_num();
        uint32_t v;
        int n = 0, i;
        char t2[8];
        if (f < 0) {
            if (f < -32768.0f)
                error(E_FC);
            v = (uint16_t)(int16_t)f;
        } else {
            if (f >= 4294967296.0f)
                error(E_FC);
            v = (uint32_t)f;
        }
        do {
            t2[n++] = "0123456789ABCDEF"[v & 15u];
            v >>= 4;
        } while (v);
        for (i = 0; i < n; i++)
            buf[i] = t2[n - 1 - i];
        push_newstr(buf, (uint16_t)n);
        return;
    }
    case KW_INKEYS: {
        int k = hal_getkey(0);
        if (k == 3)
            brk();
        if (k < 0) {
            push_newstr(NULL, 0);
            return;
        }
        buf[0] = (char)k;
        push_newstr(buf, 1);
        return;
    }
    }
    error(E_SN);
}

static void call_fn(void)
{
    uint16_t id, pid;
    var_t save;
    uint8_t *ret;
    if (*ip != TK_VAR)
        error(E_SN);
    id = RD16(ip + 1);
    ip += 3;
    if (!fndef[id])
        error(E_UF);
    pid = fnparam[id];
    paren_expr();
    save = vars[pid];
    if (vtype[pid] == VT_INT)
        vars[pid].i = pop_i16();
    else
        vars[pid].f = pop_num();
    ret = ip;
    ip = fndef[id];
    expr();
    if (*ip && *ip != ':')
        error(E_SN);
    ip = ret;
    vars[pid] = save;
    if ((vtype[id] == VT_STR) != !is_num(&vs[vsp - 1]))
        error(E_TM);
}
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
