n9wxu/fpga_cpu/basic/src/gfx.c

/* Graphics, sprites and sound (docs/io.md).
 *
 * The bitmap is 640x360, either 8-color (4 bits per pixel, [T][R][G][B],
 * left pixel in the high nibble) or hi-color (one palette index per
 * byte). Sprites are drawn in software into the hidden sprite buffer,
 * which is shown on the next VSYNC.
 */
#include "basic.h"

uint16_t vid_ctrl;

/* The palette belongs to the program: the default one is a starting
 * point. The hardware palette is write-only, so a copy is kept here, to
 * read colors back (PAL), rotate ranges and map images to whatever
 * palette is current. */
static uint8_t pal_rgb[256][3];
static uint8_t *bmp;
static int gmode; /* 0 none, 1 8-color, 2 hi-color */
static uint8_t pen = 7;
static int16_t lastx, lasty;

void vid_ctrl_set(uint16_t bits, int on)
{
    if (on)
        vid_ctrl |= bits;
    else
        vid_ctrl &= (uint16_t)~bits;
    hal_poke16(VID_CTRL, vid_ctrl);
}

static void poke32(uint32_t reg, uint32_t v)
{
    hal_poke16(reg, (uint16_t)(v & 0xFFFFu));
    hal_poke16(reg + 2, (uint16_t)(v >> 16));
}

static void default_palette(void)
{
    static const uint8_t prim[8][3] = { { 0, 0, 0 }, { 0, 0, 255 }, { 0, 255, 0 }, { 0, 255, 255 },
                                        { 255, 0, 0 }, { 255, 0, 255 }, { 255, 255, 0 }, { 255, 255, 255 } };
    int i;
    for (i = 0; i < 256; i++) {
        int r, g, b;
        if (i < 8) {
            r = prim[i][0];
            g = prim[i][1];
            b = prim[i][2];
        } else if (i < 16) { /* 8 = black, 9-15 = half-bright primaries */
            r = prim[i - 8][0] / 2;
            g = prim[i - 8][1] / 2;
            b = prim[i - 8][2] / 2;
        } else if (i < 232) { /* 6x6x6 cube */
            int c = i - 16;
            r = (c / 36) * 51;
            g = (c / 6 % 6) * 51;
            b = (c % 6) * 51;
        } else { /* gray ramp */
            r = g = b = 8 + (i - 232) * 10;
        }
        gfx_palette(i, r, g, b);
    }
}

void gfx_init(void)
{
    bmp = hal_mem(BMP_ADDR);
    default_palette(); /* sprites use the palette in every mode */
    poke32(VID_BMP, BMP_ADDR);
    poke32(VID_SPR, SPR_ADDR);
    gfx_backdrop(1);
}

void gfx_backdrop(int c) { hal_poke16(VID_BACKDROP, (uint16_t)(c & 7)); }

void gfx_palette(int i, int r, int g, int b)
{
    if (i < 0 || i > 255 || r < 0 || r > 255 || g < 0 || g > 255 || b < 0 || b > 255)
        error(E_FC);
    pal_rgb[i][0] = (uint8_t)r;
    pal_rgb[i][1] = (uint8_t)g;
    pal_rgb[i][2] = (uint8_t)b;
    hal_poke16(PAL_INDEX, (uint16_t)i);
    hal_poke16(PAL_DATA, (uint16_t)(((unsigned)(r >> 3) << 11) | ((unsigned)(g >> 2) << 5) | (unsigned)(b >> 3)));
}

void gfx_clear(int c)
{
    if (gmode == 2)
        memset(bmp, c & 0xFF, (size_t)SCR_W * SCR_H);
    else
        memset(bmp, (c & 15) * 0x11, (size_t)SCR_W * SCR_H / 2u);
}
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
