n9wxu/fpga_cpu/(commit log)

2026-10-26 Initial project layout
    Directory structure for the FPGA BASIC computer: cpu (ISA design), sim
    (C simulator), verilog (RTL + testbenches), fpga (ISE build), pcb
    (RP2350 expansion board), basic (interpreter), llvm (backend), docs.
    Includes the current architecture summary and MIT license.
2026-10-26 Simulator, GUI, assembler/linker, LLVM backend, BASIC, and web build
    - cpu/isa.yaml: table-driven ISA (two encoding variants); pair writes are
    now full 32 bits. Generated docs in cpu/gen and cpu/isa.md.
    - sim/: cycle-counting simulator generated from isa.yaml, I-cache, stream
    buffer, fusion and stall statistics, benchmarks and measurement sweep;
    all devices of docs/io.md (video, keyboard, sound, files, board I/O);
    fsim-gui (SDL2 + Dear ImGui) with registers, disassembly, breakpoints,
    step/over/out, memory, console, board and statistics windows.
    - sim/tools/asm.py: assembler and linker (multi-file, sections, library
    archives, symbol files, shortest encoding per variant).
    - llvm/: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
2026-10-26 sim: branch fusion kinds, dual issue, SRAM port counters
    - New fusion kind alu+branch (flag-setting ALU op + Bcc, so DEC+BNE acts
    as DBNZ). --fuse=LIST applies chosen kinds; candidate counts no longer
    depend on which kinds are applied.
    - In-order dual issue (--dual, --dual=ports): slot 2 takes simple ALU
    ops, MOVI or a branch; banked mode requires opposite even/odd write
    banks. Counts pairs by slot-2 class and why pairs were blocked.
    - Counters for SRAM port words used by I-fetch, and instruction bytes
    consumed per cycle. A load issued in slot 1 still delays its consumer.
    - measure.py: 12 new configurations, dual-issue, SRAM port and
    speed-per-LUT (estimated) sections.
    - Fix strd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
2026-10-26 docs: proposal for a structured BASIC and full-screen editor
    Surveys BBC BASIC, QuickBASIC/QB64, MMBasic, GFA, BASLOAD, SuperBASIC,
    Locomotive, AmigaBASIC and the PICO-8/TIC-80 editors, and proposes
    optional line numbers (numbers become labels), named labels, block
    structures, SUB/FUNCTION with LOCAL/STATIC/BYREF, a RUN-time pre-scan
    that resolves labels and block partners, error-to-line editing, and a
    staged plan against the existing interpreter.
    Claude-Session: https://claude.ai/code/session_019zBC1UZhBPcaT8BDURMeBg
2026-10-27 BASIC: programmer-owned palette, sprite attributes, collision
    Palette:
    - Indexed PNGs keep their own index numbers (PALETTE base loads the
    file's palette there and shifts the indices); true-color pixels map to
    the nearest entry of the current palette, JPEG dithered against it.
    - PALETTE LOAD reads GIMP .GPL, JASC .PAL, an indexed PNG's palette or a
    palette strip; PALETTE ROTATE cycles a range; PAL(i, c) reads back
    from a RAM copy of the write-only hardware palette.
    Sheets and sprites (new src/sprite.c):
    - Sheets are the image cache (16 of them), optionally one frame, with a
    hot spot. STAMP copies a frame into the bitmap.
    - Sprites are attribute records: frame, position, velocity (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
2026-10-27 Full-palette display switch; web page speed fixes and deploy target
    - Hi-color (8-bit indexed) bitmap can now be shown with the full
    256-entry palette as well as the board's 3-bit dither: a selector in
    fsim-gui's Controls and a Colors menu (or ?color=full) on the web page.
    - web: run and render are separate calls, and a frame does at most about
    10 ms of simulation, so a slow browser slows the machine instead of
    freezing the page. The status line shows CPU and draw time per frame,
    the browser, and when real time is out of reach.
    - web: `make deploy` copies the build to the retro container. README
    notes that Safari needs HTTPS (or localhost) to compile WebAssembly.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
2026-10-27 CI with GitHub Actions, Pages deployment, and a new README
    - .github/workflows/ci.yml: simulator tests, BASIC host tests, and a
    toolchain job that builds LLVM with the FCPU backend (cached on a hash
    of its inputs, ccache on a miss), runs the compiler tests and BASIC in
    the simulator on both encodings, and builds the web simulator with
    Emscripten 5.0.3. Pushes to main deploy it to GitHub Pages.
    - README: live demo link, what works, quick start, layout.
    - sim: build with -std=gnu11. With -std=c11, glibc hides strdup, which then
    returned a truncated int and broke the device tests on Linux.
    - llvm/setup.sh: use ccache when installed.
    - web: the deploy target comes from DEPLOY or an unt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
2026-10-27 fcc --int32: use an int32 target feature instead of a triple environment
    The clang driver rejects unknown triple environments, so 32-bit int is now
    the +int32 target feature (FCPUTargetInfo::handleTargetFeatures), declared
    as a SubtargetFeature so the backend accepts it. Runtime tests pass on A,
    B and A/int32.
    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
2026-10-28 Web simulator: debugger panels; run control shared with fsim-gui
    sim/src/dbg.c holds breakpoints and step/over/out for both front ends.
    Step out now counts calls, so it no longer stops at a callee's return.
    The page's Debug button opens registers, disassembly with symbols and
    breakpoints, memory, statistics, board I/O and the serial console.
2026-10-28 Compiler: Doom's pixel loops twice as fast; draw-loop benchmark and hand versions
    benchmarks/c/doomdraw: R_DrawColumn and R_DrawSpan alone on a frame-like
    mix, checked against the host, in cycles per pixel. doomdraw (C) and
    doomdraw-asm (hand-written, doom/port/r_draw_fcpu.s); doom-asm is Doom
    with the hand versions (FCPU_DRAW_ASM), which the Makefile and the web
    build now use (DRAW=c for the C).
    Column / span cycles per pixel: 30.0 / 38.0 -> 15.4 / 18.6 compiled,
    11.8 / 14.1 by hand. Doom: 6.25 -> 7.46 fps (C), 8.37 fps (hand).
    All benchmarks: 1.15x geomean, code ~12% smaller.
    Backend changes:
    - i32 AND/OR/XOR and MUL split into i16 halves while lowering, looking
    through halves already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
2026-10-29 Core ladder c0-c3: selectable timing and compiler scheduling models
    fsim --core c0|c1|c2|c3 selects a core configuration (1-cycle branch +
    fusion, 4 KB I-cache, asymmetric second pipe); later options override
    parts of it. Adds --dual-ops/--dual-16/--dual-any slot controls.
    fcc --cpu=generic|fcpu1|fcpu2 selects an LLVM scheduling model
    (FCPUSchedule.td): single-issue with load-use latency, or two pipes.
    Pre- and post-RA machine scheduling with a macro-fusion mutation that
    keeps flag setters next to Bcc. generic output is unchanged.
    run.py gains core configs; docs/cores.md records the measured ladder
    (c3: 1.53x over c0, Doom 6.29 -> 9.62 fps) and speed-per-LUT estimates.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
2026-10-31 basic: sprite position/velocity arithmetic safe on a 16-bit int
2026-10-31 basic: bound list_line and expression depth, fix LOAD handle leak, stale state after edits, silent truncations
    list_line takes a buffer size (SAVE/LOAD/LIST use a 1280-byte buffer; SAVE errors LINE TOO LONG if a line cannot round-trip). Expression depth limit (FORMULA TOO COMPLEX). Integer FOR rejects non-integral STEP. LOAD closes its file on error and rejects unnumbered lines. Edits reset the control stack and DATA pointers. Backslash truncates toward zero for floats. VAL/READ/INPUT no longer convert a 39-char prefix. Names without a dot always get .BAS. emit_raw errors instead of clamping. Regression tests in tests/robustness.bas.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
2026-10-31 sim: no-I-cache data port contention, FS transfer clamp, option validation, decode fixes
    - decoder treats an odd pair number as illegal (no alias to the even pair)
    - predecode fetches the second parcel only for 32-bit instructions
    - with --icache 0 each SRAM data access takes its own cycle after the fetch
    - READ/WRITE count clamped to 32767 (FS_RESULT is signed 16 bits)
    - --video P:B requires B < P; --branch-pen and numeric options are validated
    - mem_wr8 masks to 8 bits; data accesses are logged only after fault checks
2026-10-31 libc: printf with exact decimal digits: %g, # flag, hh/z/t/j, any precision, large values, -0.0; snprintf(NULL,0)
2026-10-31 printf test: check %#g power-of-ten carry against the standard, not glibc
    glibc drops the trailing zeros that '#' requires when %g rounding carries
    into the next power of ten (%#g of 999999.5 gives 1.e+06, not
    1.00000e+06), which failed the toolchain job on the Ubuntu runner. Those
    two cases now compare with the C standard's output.
2026-11-01 FPGA build: ISE over ssh, Opella-LD programming, 1280x720 text video
    The fpga/ flow now runs end to end from the Mac: `make bit` builds with
    ISE 14.7 on the Linux host, `make prog` loads the Spartan-3 Starter Board
    through an Ashling Opella-LD (an FT2232) with OpenOCD.
    - board_test: seconds 0000-9999 on the seven-segment display, a Larson
    scanner on the LEDs, and on VGA a demo screen of the fpga_cpu's video:
    1280x720 60 Hz, 640x360 logical shown 2x, the 80x25 text layer in the
    docs/io.md cell format with the simulator's 8x14 CP437 font. The count is
    written into text RAM from the 50 MHz side.
    - 74.25 MHz pixel clock from two DCMs in series (50 x 27/20 x 11/10). One
    DCM's 75 MHz ma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
2026-11-01 FPGA: T1 system on the Spartan-3 with 640x360 video and a demoscene demo
    T1 runs at 10 MHz on a gated 50 MHz clock and shares the 1 MB SRAM with
    video DMA and the JTAG loader. The video follows docs/io.md at 1280x720
    (backdrop, bitmap with palette and dither, 80x25 text) and matches fsim's
    screenshots in simulation. JTAG USER1/USER2 load programs and run or hold
    T1; tools/jtagload.py allows for this board's one-bit framing offset.
    fpga/demo/demo.c: plasma, palette cycling, scroll wobble, 3D stars, a
    scroller and live statistics; measured 60 fps, 1.81 MIPS, CPI 5.5.
2026-11-01 Tang Nano 20K: T1 with serial loader, 720p HDMI output
    Open toolchain (yosys, nextpnr-himbaechel, gowin_pack, openFPGALoader).
    t1tang: T1 at 16.875 MHz with 64 KB of block RAM, loading and console
    over the USB serial port (systest and t1check pass on the board).
    hdmitest: 1280x720 60 Hz DVI through OSER10 serializers and TLVDS pairs,
    verified on a TV.
2026-11-01 Tang: fpga_cpu video on HDMI, shared video and I/O with the Spartan-3
    tang/rtl/system.v (was t1tang.v): T1, 64 KB of dual-port block RAM byte
    lanes (video DMA on the second port), fpga/rtl/video.v in true colour and
    fpga/rtl/iosys.v, HDMI with an AVI InfoFrame (underscan, IT content).
    video.v gains a 24-bit output with data enable; iosys.v takes CON_IN.
    The Spartan-3 video still equals fsim's frames; on the Tang, the
    vidtest frame equals fsim's but for the live counters.
2026-11-01 Tang: SDRAM controller, T1 on a gated clock, video from SDRAM
    T1's clock is a DQCE-gated 67.5 MHz clock: 4 clocks per cycle for block
    RAM (000000-00FFFF) and I/O, longer while the SDRAM answers. sdram.v runs
    the in-package 64 Mbit SDRAM for T1 and video DMA: CAS 2, open rows,
    SDRAM clock at 180 degrees, a cycle between reads (back-to-back reads
    sometimes captured the next word on the board). sdtest passes on the
    board; systest passes in simulation against sim/sdram_model.v.
2026-11-01 Stippled text backgrounds blend 50% on true-color video
    On a true-color display (the Tang's HDMI, fsim --true-color) attribute
    bit 15 now draws the background as a 50% blend with what is beneath,
    instead of a checkerboard; 3-bit video is unchanged. The Tang frame of
    tang/progs/blendtest.c equals fsim --true-color's; the Spartan-3 video
    still equals fsim's. The Tang testbench can dump 24-bit frames (+rgb24),
    and the SDRAM model starts zeroed, like fsim's memory.
2026-11-03 T1S pipelined fetch on the RAM machine; T1F/T1S decode-clock fix
    - T1F/T1S: decode the instruction's last byte straight from din instead
    of spending an extra S_DEC clock on almost every instruction; T1F now
    takes no more cycles than T1 on any benchmark.
    - T1S: a fetch unit with its own 32-bit instruction port, a landing
    buffer and a 4-parcel queue (2 instructions in flight); the data bus
    carries only loads and stores. Flush on jumps and on stores near PC.
    - ramsys: the Spartan-3 RAM machine (rammux, sram_phy bursts, cpumem
    write/word buffers, fbvideo, loader); instruction fetch on its own
    rammux port. 0 timing errors, 3,747 / 3,840 LUTs.
    - Testbench: instruction-port model with l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
2026-11-03 Spartan-3 low tier: 16-colour video, sound, six-section demo
    Video and I/O
    - video.v: HICOL8 parameter. The Spartan-3 is the low video tier: 4-bit
    bitmaps only, 8-colour or the new 16-colour direct mode (VID_CTRL bit 7:
    9-15 are 1-7 at half brightness, 8 transparent), no palette, half the line
    buffer. The Tang keeps 256 colours (high tier).
    - iosys.v: low tier drops the palette, sprite registers and unused VID_CTRL
    bits; INSTRET (F00010, 32-bit instructions retired); line counter fix
    (the toggle and line_top crossed with one clock of margin: a frame in
    three went uncounted, FRAME at 40 Hz on one build).
    - jtagldr.v / jtagload.py: drop each USER1 scan's first word. The 31-bit
    st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
2026-11-04 Tang: SDRAM bursts, cache and audio engine; HDMI on emulated LVDS
    SDRAM: 8-word burst reads (DQM-masked), single writes, the SDRAM clock in
    phase with fclk (bursts failed at 180 degrees on some placements), capture
    settable over serial, a self-test (C/D/E/B). A 32 KB write-through cache in
    front of rammux; the audio engine on rammux port 2 into HDMI audio.
    HDMI: the output is now ELVDS_OBUF (3.3 V, 8 mA), as NESTang and the Gowin
    tools drive this board. With TLVDS_OBUF the FPGA's own switching noise broke
    the link: the TV blanked and muted whenever the system played music with
    audio packets on. Traced on the board with a camera on the TV: the packets
    the system builds are correct (captured,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
2026-11-04 modplay: an Amiga MOD tracker for the Tang Nano 20K
    Plays 4-channel ProTracker MODs on the audio engine and shows them as a
    tracker: song position, pattern, row, speed and BPM, a scrolling 4-channel
    pattern view with the playing row highlighted, the sample list and a panel
    per channel with note, sample, volume, effect and a VU meter.
    The replayer is ProTracker 2: speed/BPM, all 16 finetunes, and the standard
    effects (arpeggio, slides, tone portamento, vibrato, tremolo, panning, sample
    offset, volume slides, jumps, breaks, loops, retrigger, cut, delay, pattern
    delay). Ticks are timed by the engine's 48 kHz frame counter; samples play in
    place from the MOD in SDRAM on engine voices 0-3. tools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
2026-11-04 T1S interrupt and interrupt controller on the Spartan-3
    A PIC-style interrupt on T1S: before an instruction, with IE set and an
    interrupt pending, EPC <- PC, IE <- 0, PC <- 0x000010. RETI (0xA300)
    returns with PC <- EPC, IE <- 1; MTSR SR6 bit 0 sets IE. The handler saves
    the flags (MFSR/MTSR SR0) and any registers itself. The entry is a
    next-state override so the decode path is unchanged (timing met, 42 ps).
    Interrupt controller at F00700 (pending, enable, software set; bit 0
    vertical blank, bit 7 software, bits 1-6 for devices) in iosys, enabled on
    ramsys. fsim models both; irq.s runs in lockstep on T1S and irqtest.c on
    the RTL system. cpumem: an I/O write no longer holds the clock enable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
2026-11-04 Spartan-3 expansion board schematic (rough)
    A KiCad 10 schematic generated by gen_sch.py: PCM5102A I2S audio on A2,
    PS/2 mouse with BSS138 level shifters, microSD over SPI, two NES pads,
    an ESP32-WROOM-32E on its own SPI, handshake, EN/IO0 and UART pins, and a
    512 KB NOR flash on A1 sharing the SRAM address and data bus for
    execute-in-place ROM. ERC clean; PDF included.
2026-11-04 Tang video: playfield B, line scroll, sprites, double buffering, blitter
    fpga/rtl/video.v (EXT = 1, the Tang only): each logical line fetches the
    line-scroll entry, playfield A, playfield B, the sprite buffer row and the
    text row, then builds the hardware sprites' line (64 sprites up to 32x32,
    16 a line, flip) in a line buffer; the pixel side takes the front-most
    opaque layer and reads the palette once. Buffer addresses are taken at the
    start of each frame (VID_STAT bit 0: a flip pending).
    tang/rtl/vidx_regs.v: the F00220 registers. tang/rtl/blitter.v: rectangle
    copy and fill with strides and a colour key on a fifth rammux port; it
    invalidates the CPU cache's lines it writes.
    tang/progs/vi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
2026-11-04 Two PS/2 ports on the Spartan-3, with a keyboard and mouse driver
    ps2.v: a PS/2 port that moves whole bytes each way. It holds the clock
    low until a received byte is read (no overruns), drops frames with bad
    parity or stop bits, and sends with the request-to-send and the device's
    acknowledge; a send nothing clocks ends with "no device". Two ports in
    iosys (PS2=1) at F00300-F00306, interrupt sources 1 and 2. On ramsys,
    A is the board's connector (M16/M15) and B is A2 pins 7-8 (D6/C6).
    fpga/lib: irq.c (an entry stub and a handler for each source) and
    ps2.c, which resets and identifies the device in each port (keyboard or
    mouse, either port), decodes set-2 scan codes into the KBD_DATA key code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
2026-11-04 ramsys: the low tier's own copy of the video (video_lt.v)
    With the Tang's video extensions (#16) video.v cost the Spartan-3 over
    100 LUTs even with EXT = 0 and every extension input tied off (mostly
    the general line fetch), and ramsys with the PS/2 ports no longer fit
    (3,959 of 3,840 LUTs). video_lt.v is video.v as it was before the
    extensions; ramsys uses it and fits again: 3,834 of 3,840 LUTs, timing
    met (0.279 ns). The three video test frames match fsim pixel for pixel;
    on the board the demo runs at 60 fps, 3.75 MIPS.
2026-11-05 The Future: a ten-minute demo, from a one-bit screen to the stars
    People fly jets, then rockets, land on the Moon, build a space station
    and a Moon base, cross the solar system and leave for the stars. The
    computer drawing it grows with them:
    - the picture, from a 1-bit 128 x 72 screen with a beeper, through CGA
    colours, an Apple II lunar lander and the 16-bit era, to 640 x 360 in
    256 colours with every layer of the Tang;
    - the music, an original uplifting techno track at 128 BPM in 40 phrases,
    from one square voice, through a sound chip and a SID, to 4, 8, 16 and
    32 sample and chip voices.
    The scenes:
    - time-functional on the song position, so -DSTART=p starts anywhere;
    - the Moon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
2026-11-05 Overdrive: a high-energy rave demo
    About three and a half minutes in the manner of the early-90s rave
    demos, all original.
    The music is a rave track at 150 BPM in A minor on all 32 voices:
    - hard kick, claps and hats; a galloping bass and sub;
    - an acid line through the resonant filter;
    - rave stabs, a 5-saw lead that swoops into its notes, piano arpeggios;
    - a pad that ducks under the kick;
    - snare-roll builds up to 32nds, and one last hit.
    The pictures cut on the beat, flash and shake on the kick, and strobe on
    the clap. Most of it runs at 60 fps, done by the hardware:
    - palette-animated fields: a plasma, a tunnel from a precomputed
    quadrant, and raster bars;
    - line scroll bends and te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
2026-11-05 demos: sprite registers written in vertical blank
    The demos wrote sprite attributes while the screen was being drawn (the
    vector balls one by one as they were projected), so sprites tore: the
    hardware takes a write from the next line. spr_set, spr_xy and spr_off
    now write a shadow in RAM. vsync() and wait_flip(), which return at the
    start of vertical blank (FRAME counts at line 719), copy the changed
    words to the hardware in one burst. This fixes demo80s, The Future and
    Overdrive, which share hw.h.
2026-11-05 T1F interrupts, and the Tang's interrupt controller
    t1f_core gets a parameter IRQ: an irq input, EPC and IE, as on T1S
    (docs/t1.md "Interrupts").
    - At an instruction's end, with IE set and the line high, the next
    instruction does not start: EPC takes its address (past a jump the
    target, else the PC less the bytes prefetched), IE clears, and fetching
    restarts at 0x000010.
    - RETI jumps back and sets IE; MTSR SR6 sets IE.
    - With IRQ = 0, as on the Spartan-3, nothing changes.
    The Tang system turns it on, with iosys's controller at F00700. Sources:
    - 0: the vertical blank;
    - 3: new, the audio engine's voice interrupt flags.
    fpga/lib/irq.c installs the handlers (IRQ_AUDIO added to irq.h).
    T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
2026-11-05 Simulators: pick a program and the hardware
    Hardware profiles, shared by fsim, fsim-gui and the web page (--hw):
    - sim: the reference machine;
    - spartan3: the low tier, 1 MB, 3 MHz (about T1F's 2 MIPS on the board);
    - tang: the high tier in true colour, 8 MB, 10 MHz (about T1F's 6.5 MIPS);
    - big: 15 MB, for Doom.
    A profile sets the video tier, RAM, colours and clock. The clock is now
    a variable (dev_cpu_hz); video timing and the low tier's sound follow it.
    On the board's own meters the clocks give 2.14 and 6.5 MIPS.
    sim/tools/programs.py builds the demos and benchmarks into
    sim/build/programs and lists them in catalog.tsv (and .json):
    - Overdrive, The Future, demo80s;
    - fpga/demo for the Ta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
2026-11-05 Spartan-3: flash ROM, Genesis pads, software SID; three cuts pay for them
    The flash ROM (SST39VF1601C, 8 bits used: 512 KB) shares the SRAM's bus
    on A1 with its own CE# (M7) and A18 (P9), read byte by byte at
    F80000-FFFFFF: sram_phy.v's flash cycle, cpumem.v's window; a
    behavioural model with timing checks (sim/sst39vf.v), a driver
    (lib/flash.c: ID, sector erase, program) and flashtest.
    Two Sega Genesis pads (3- or 6-button) on A2: PADS at F00900, the
    select line out and both pads' six lines in; software runs the protocol
    (lib/pad.c). A pad model for the RTL (sim/genesis_pad.v) and fsim
    (--pad N,TYPE,BUTTONS); padtest.
    Cuts: INSTRET_LO read through SR3; PS/2 sending in software (STAT
    drive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
2026-11-05 Tang video: buffers anywhere in the 8 MB SDRAM
    video.v gets a parameter AW, the buffer address bits: 20 by default (the
    Spartan-3, 1 MB), 23 on the Tang. Every layer can then be anywhere in the
    8 MB: text, playfield A, sprite buffer, playfield B, the line-scroll table,
    and a hardware sprite's pixels. The sprite address uses bits 6:0 of
    attribute word 3 for address bits 22:16. The Tang's video DMA port now
    carries a 21-bit word address, as the blitter and audio ports already did.
    fsim matches: on the high tier, video reads and the blitter reach all of
    RAM (--xram); the sprite address takes 7 high bits.
    Placement: fclk's margin is thin. Seed 5 passes at 68.7 MHz (needs 67.5);
    the Makefile re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
2026-11-05 Expansion board: Sega Genesis pads on DE9s; the flash as the RTL has it
    Two Genesis pads (3- or 6-button) replace the NES pads: DE9 plugs as
    on the console, 5 V through polyfuses, one select line for both at 5 V
    (74AHCT1G125), the 12 inputs back through two 74LVC245A at 3.3 V with
    pull-ups (no pad reads as none). A2 pins 14-17 and 27-35 (35 is D9,
    the oscillator socket's: keep it empty). The flash's CE# and A18 move
    to pins 21 (M7) and 20 (P9) as in ramsys.ucf; its notes are the
    SST39VF1601C's. The sheet is A2 now.
2026-11-05 Tang: T1F synchronous on fclk; every path timed
    T1F (SYNC = 1) runs on fclk. Its step's clock is enabled by the end of
    the bus period, where the DQCE used to let T1's edge through; its first
    clock always is. The cache, I/O and line-fill handshakes are unchanged:
    a period is still at least 4 fclk clocks. The paths from T1F's bus to
    the cache and I/O, untimed until now, are ordinary fclk paths, and
    system.sdc drops cpu.clk. A T1 build (CORE=t1) keeps the gated clock.
    The design fills about 99% of the LUT sites. Seeds 3 and 6 place and
    pass (fclk 67.7 and 68.5 MHz); the Makefile takes 6.
    On the board (seed 6), all pass:
    - xramtest, irqtest, vidhigh;
    - audtest, with no underruns;
    - Overdrive p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
2026-11-06 Tang: write-only I/O registers, flash boot with a BIOS and Toolkit ROM, microcoded audio
    - Write-only video, blitter and audio control registers, narrower audio internals: the gates
    the synchronous T1F needs.
    - SPI flash: the bitstream and a ROM image boot from the on-board flash; the ROM (rom/) is
    copied to RAM, a BIOS and a Toolkit shell; programs exit back to it (crt0). docs/rom.md.
    - The microcoded audio engine (fpga/rtl/mcaudio, make mcaudio): a 72-bit micro-word core,
    control store loaded by the CPU, a node list in SDRAM; assembler, tests. docs/mcaudio.md.
    - Simulator: the flash, the write-only registers.
2026-11-06 apps/sym40: Mozart's Symphony No. 40 for orchestra, with a falling-notes visualizer
    A stress test for the microcoded engine (sampled strings and horns, oscillator winds) and the
    video: notes fall on playfield B onto a keyboard lit in each section's colour, a white-hot
    flash and a spray of sparks where they land, bouncing balls and a fire below.
2026-11-06 apps/toccata: Bach's Toccata and Fugue in D minor, complete, on a 64-node pipe organ
    The whole of BWV 565 from the Mutopia Project's public-domain edition (data/ToccataFugue.mid,
    piece 1780), with the edition's tempo marks as a tempo map, the opening's mordents and fermatas,
    in real time. The organ: a registration's flue ranks (8', 4', 2 2/3', 2') drawn into one sample,
    band-limited in four ranges; at full organ a detuned reed node beats against it; the pedals at 16'.
    Notes come from a pool of 64 engine nodes; a released note rings on as the church's tail until the
    pool needs it, and silent nodes are skipped. The engine's cost a node is measured at start and the
    voices sounding at once cappe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
2026-11-06 Paint for the Spartan-3, with windows; a PS/2 wheel mouse
    apps/paint: an 8-colour paint program for the ramsys design, driven by a
    3-button PS/2 mouse with a wheel (and a keyboard, if one is plugged in).
    16 tools (select, colour picker, pencil, brush, spray, eraser, bucket,
    text, line, curve, rectangle, rounded rectangle, ellipse, polygon,
    magnifier, hand), 16 patterns, outline/filled/framed shapes, cut, copy,
    paste, flips, invert, up to 96 steps of undo and redo (each operation's
    changed rectangle in a log), zoom 1x-8x.
    The screen is a desktop of windows in the toolbox's look: picture windows
    (up to three views of the picture, each with its own zoom, scroll bars and
    grow box) and the Tools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
2026-11-06 sid6502: a 6502 interpreter and JIT for C64 SID tunes on fpga_cpu
    Runs a .sid file's 6502 music routine and records every SID register
    write with its 6502 cycle. Two engines share one state: an exact-cycle
    interpreter (every documented and stable undocumented opcode) and a JIT
    that translates 6502 traces to fpga_cpu code and links them. Both agree
    with an independent Python reference on 3,175 tests, cycle for cycle
    (make host, make test).
2026-11-06 sidplay: a SID tracker for the Tang Nano 20K
    Plays PSID tunes through sid6502 on the audio engine and shows them as a
    three-voice tracker: the pattern view rebuilt from the SID writes, the
    instruments, per-voice state with envelopes and scopes, the filter. Three
    original tunes (tunes/, tools/mktunes.py); the built-in one plays when no
    SDRAM slot holds a tune.
2026-11-06 fsim: the Tang's audio engines, sample for sample, with sound in the GUI and the web page
    - src/audeng.c: the 32-voice audio engine (docs/audio.md), a port of
    fpga/tools/audio_ref.py; tools/audeng_check.py compares the two frame
    for frame on audio_tests.py's scripts (in make test).
    - src/mcaud.c: the microcoded engine (docs/mcaudio.md), its sequencer
    run word by word on the control store the program loads, with the
    pipeline's timing; tools/mcaud_check.py compares it with the RTL
    (iverilog, tools/mcaud_tb.v): 28 runs, samples, RAM write-back,
    monitor and counters bit exact.
    - src/snd.c: the sound device's frames, made as the CPU's cycle count
    passes them (cpu_step), go to a ring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
2026-11-06 Web simulator: the hardware's sound device
    web_set_hw set the video tier and the clock but not the sound device, so
    every machine in the page had none and the Tang's music was silent.
2026-11-06 T1M: a tracker module format for the Tang's audio, a player and a demo song
    docs/t1m.md: a player format that says what the music is (notes, cents,
    ms, Hz, levels) and never how an engine makes it: no microcode, routine
    numbers or engine memory layout. Oscillators (saw, triangle, pulse with
    PWM, noise), 8- and 16-bit samples, hard-sync and ring pairs, ADSR, an
    LFO for vibrato and PWM, unison, per-tick sequences, up to 4 filters with
    LFO sweeps, 32 channels, two effect columns.
    apps/t1mplay: tools/t1mc.py compiles the text source (.t1s) to a .t1m
    and dumps one back; src/t1m.c plays it on the microcoded engine (the
    player owns the mapping: which routine a voice runs, what is hardware
    and what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
2026-11-06 T1M: Mozart's 40th and Bach's Toccata and Fugue as modules; the players in the picker
    songs/convert.py reads apps/sym40's and apps/toccata's notes and samples
    from their own generators and says them the T1M way: each engine setting
    back in ms, Hz, cents and levels. sym40: 15 channels, its sampled strings
    and horns, the winds through a low-pass. toccata: complete, 12 parts on
    24 channels (flue and, at full organ, reed), 24 pipe samples as range
    instruments. In fsim their loudness follows the originals (correlation
    0.96 and 0.89 over 12 s; levels within 8% and 2%).
    The Makefile builds the player with each song built in (demo, sym40,
    toccata); the simulators' picker has all three on tang-mc.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
2026-11-06 T1M: tails (new-note action release) and a voice pool; staged node writes
    A note released by its channel's next note can now ring on in the background
    (an organ pipe after its key, a struck bell) while the next one plays; the
    same note again restarts its own voice. The format gains the new-note action
    (INST byte 45: cut or release), the duplicate check (byte 46), effect 19 (cut
    the channel's tails; the playing note's action) and needs bit 8.
    The player takes voices from a pool of the engine's nodes instead of fixed
    per-channel nodes: a tail lives until its release has died away (-60 dB), or
    until a note needs its nodes or the engine's time (a block budget from the
    measured cost per routine)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
2026-11-06 Web: the apps in the program menu (the music players and Paint)
    The page listed only the catalogue's demos and benchmarks, so the apps (the SID
    and MOD trackers, Mozart, Bach, the three T1M songs, Paint) could not be picked
    or named with ?prog=. They get their own group; BASIC stays under Programs.
    Every sound program, recorded through the page's audio callback in Chrome, plays
    as fsim does on the same hardware (each on its own device: the 3-voice device,
    the Spartan-3 player, the Tang's engine, the microcoded engine).
